maartendemunck/earth-rover/software/remote-control/human-machine-interface-display/images/layout-active-off.png

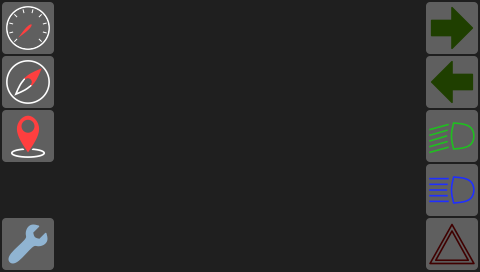
software/remote-control/human-machine-interface-display/images/layout-active-off.png
