maartendemunck/earth-rover/software/remote-control/human-machine-interface-display/images/layout-page-compass.png

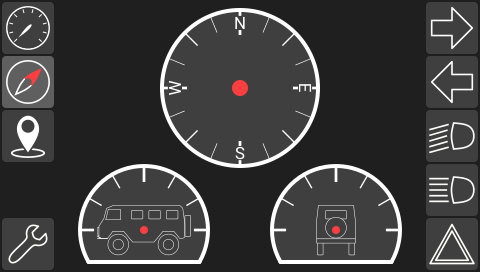
software/remote-control/human-machine-interface-display/images/layout-page-compass.png
