maartendemunck/earth-rover/software/remote-control/human-machine-interface-display/images/layout-page-gps.png

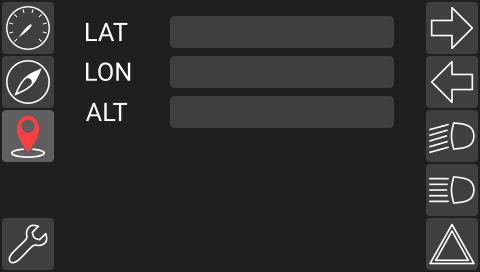
software/remote-control/human-machine-interface-display/images/layout-page-gps.png
