maartendemunck/earth-rover/software/remote-control/human-machine-interface-display/images/layout-page-speedometer.png

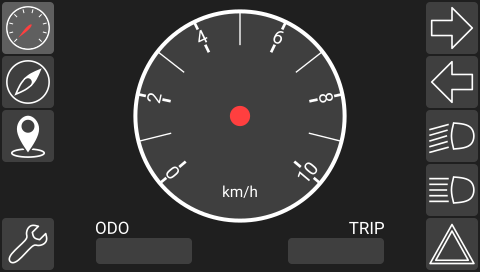
software/remote-control/human-machine-interface-display/images/layout-page-speedometer.png
