maartendemunck/earth-rover/software/remote-control/human-machine-interface-display/images/layout-settings-page-gearbox-active.png

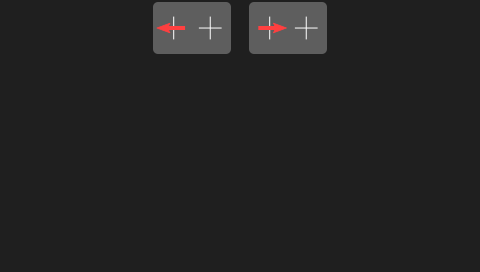
software/remote-control/human-machine-interface-display/images/layout-settings-page-gearbox-active.png
