maartendemunck/earth-rover/software/remote-control/human-machine-interface-display/images/layout-settings-page-gearbox.png

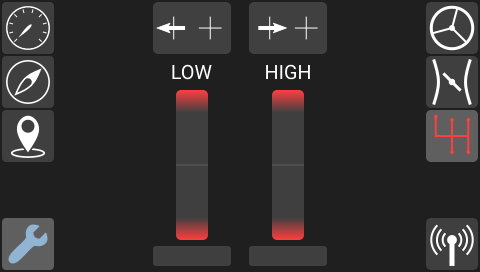
software/remote-control/human-machine-interface-display/images/layout-settings-page-gearbox.png
