maartendemunck/earth-rover/software/remote-control/human-machine-interface-display/images/layout-settings-page-steering-active.png

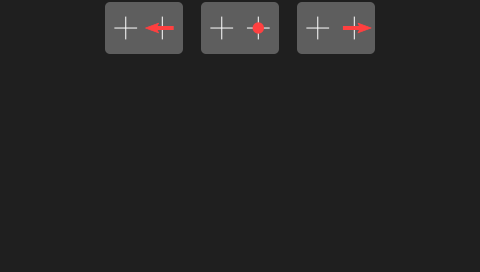
software/remote-control/human-machine-interface-display/images/layout-settings-page-steering-active.png
