maartendemunck/earth-rover/software/remote-control/human-machine-interface-display/images/layout-settings-page-steering.png

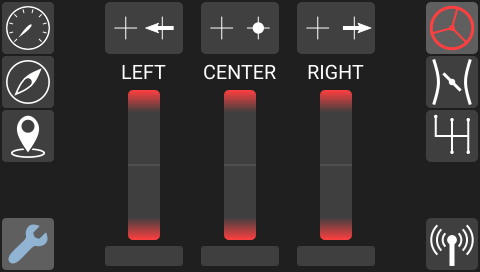
software/remote-control/human-machine-interface-display/images/layout-settings-page-steering.png
