maartendemunck/earth-rover/documentation/src/images/electronics-block-diagram.pdf

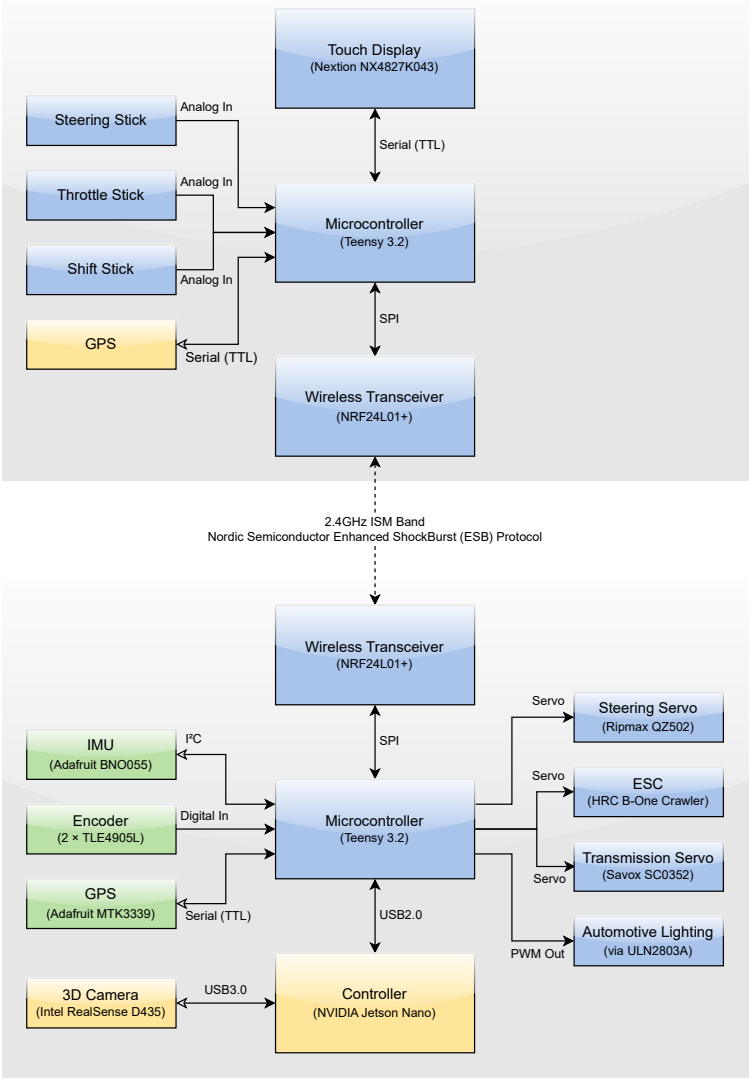
[picture p11: page 1]
Serial (TTL); Touch Display (Nextion NX4827K043); SPI; Microcontroller (Teensy 3.2); Analog In; Steering Stick; 2.4GHz ISM Band; Wireless Transceiver; (NRF24L01+); Wireless Transceiver (NRF24L01+); USB2.0; Servo; PWM Out; Throttle Stick; Shift Stick; I²C IMU; (Adafruit BNO055); GPS; (Adafruit MTK3339); ESC; Steering Servo; (Ripmax QZ502); Transmission Servo (Savox SC0352); USB3.0 3D Camera; (Intel RealSense D435); Automotive Lighting; (via ULN2803A)

Nordic Semiconductor Enhanced ShockBurst (ESB) Protocol

(HRC B-One Crawler)

Digital In Encoder
(2 × TLE4905L)

Controller
(NVIDIA Jetson Nano)
