maartendemunck/earth-rover/documentation/src/images/software-block-diagram.pdf

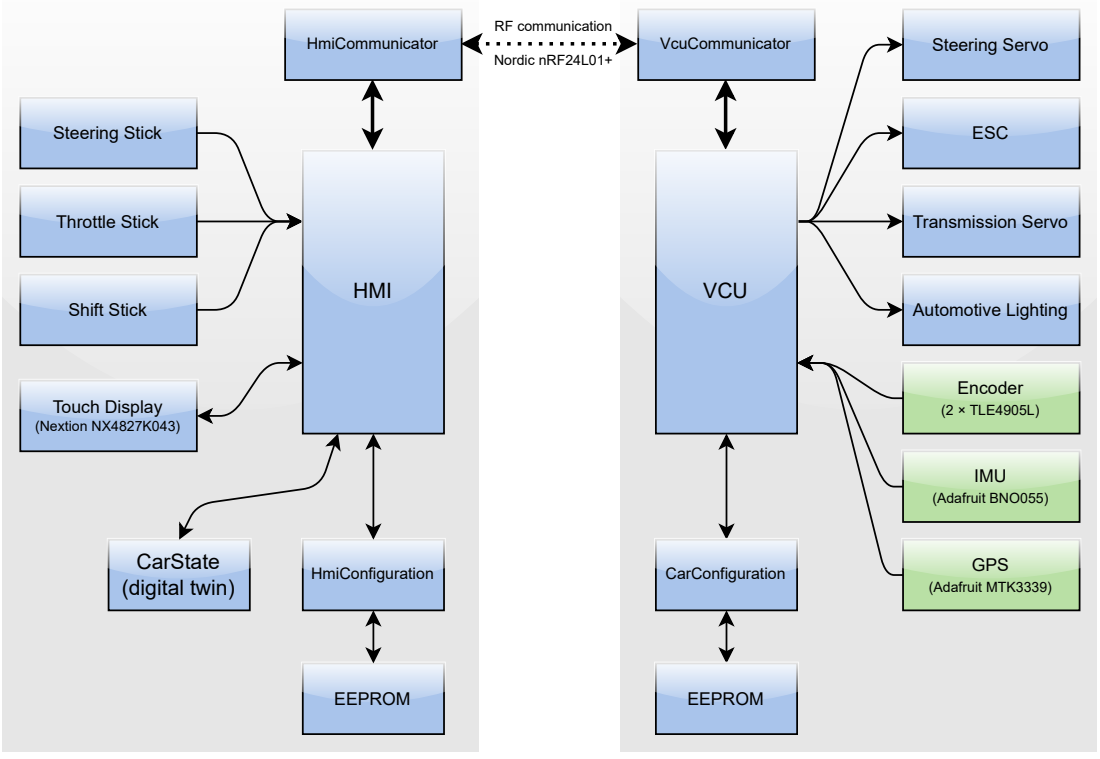
[picture p12: page 1]
Touch Display (Nextion NX4827K043); Steering Stick; VcuCommunicator; Throttle Stick; Shift Stick; Encoder; (2 × TLE4905L); IMU; (Adafruit BNO055); GPS; (Adafruit MTK3339); ESC; Steering Servo; Transmission Servo; Automotive Lighting; HMI; RF communication; Nordic nRF24L01+; HmiCommunicator; VCU; CarConfiguration; EEPROM; HmiConfiguration; CarState (digital twin)
