maartendemunck/earth-rover/electronics/vehicle-control-unit/vehicle-control-unit.kicad_pcb

## KiCad design electronics/vehicle-control-unit/vehicle-control-unit.kicad_pcb (2023-01-23)

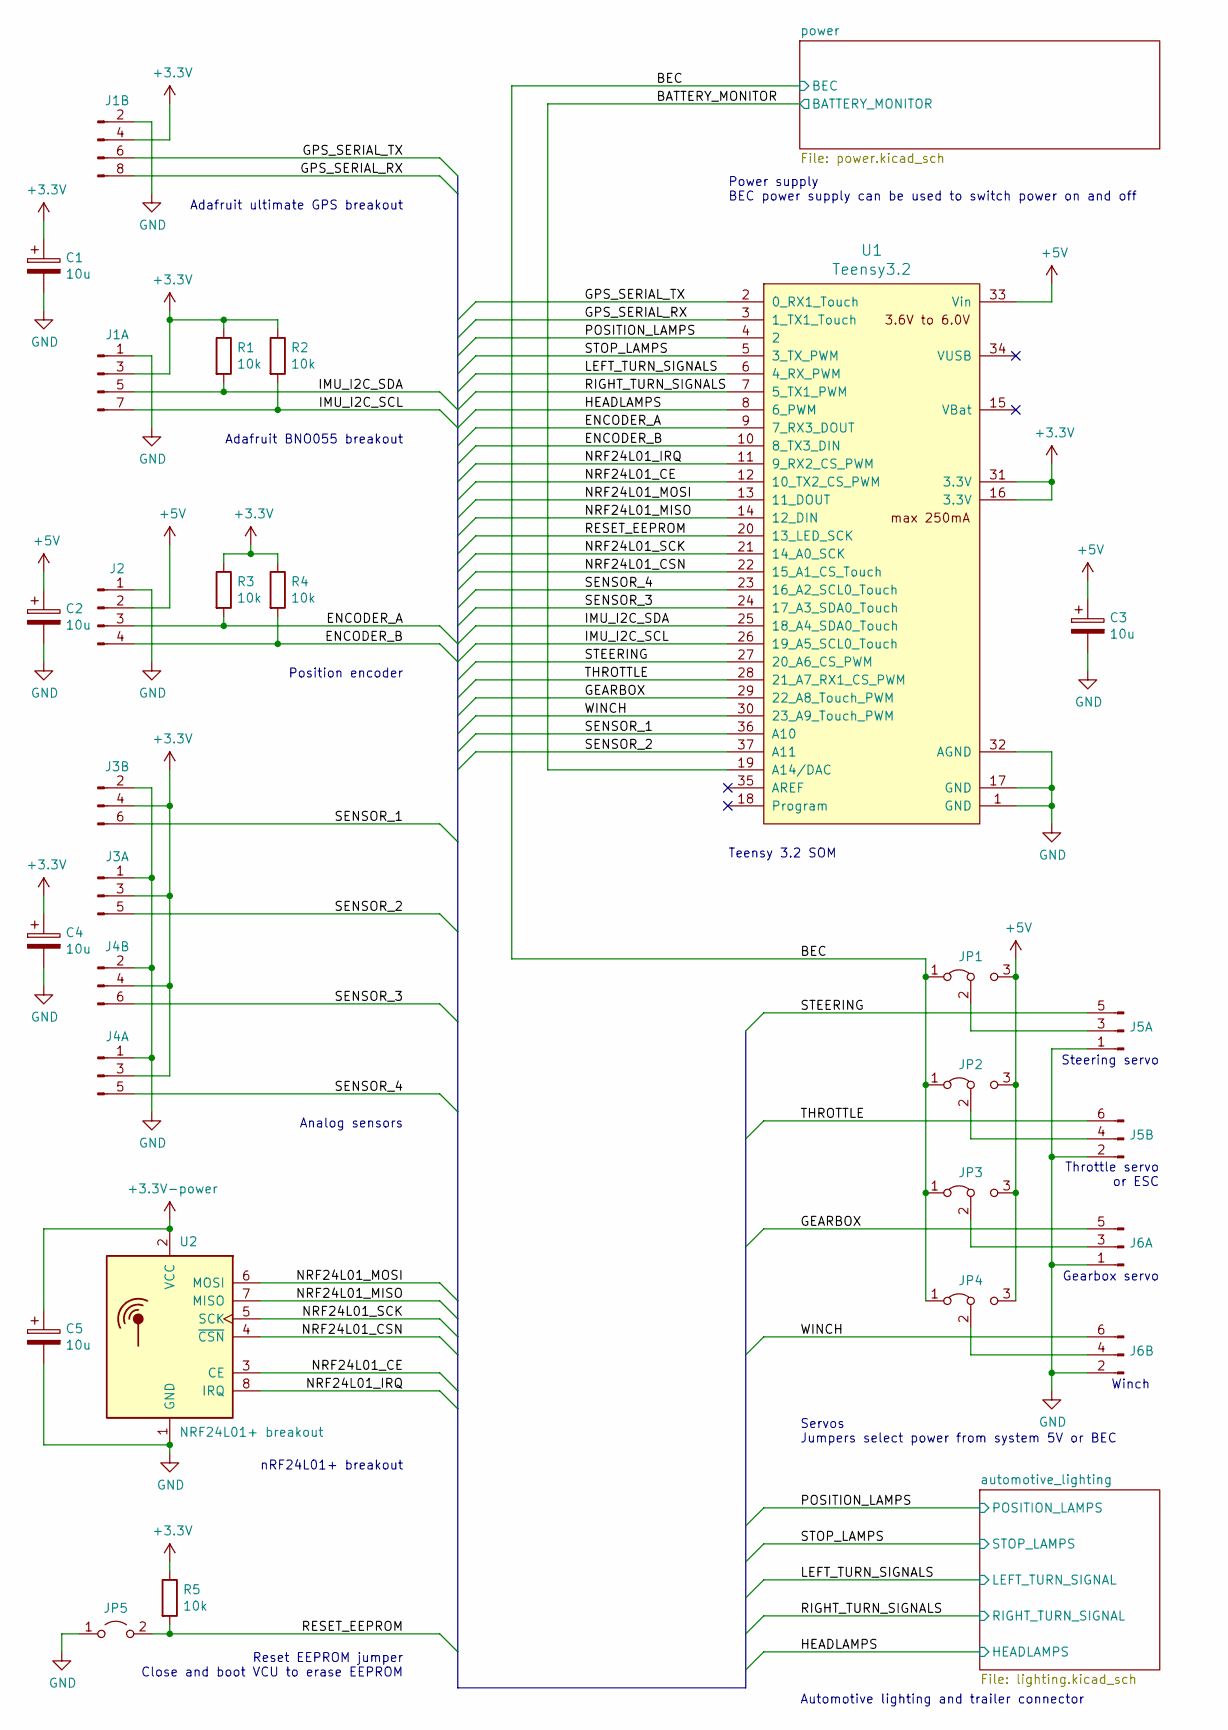
[picture p13: schematic vehicle-control-unit.kicad_sch, Earth Rover]

Parts:
C1, C2, C3, C4, C5: 10u; CP_Radial_D5.0mm_P2.50mm
J1: Conn_02x04_Male_UnitPerRow; PinHeader_2x04_P2.54mm_Horizontal
J2: Conn_01x04_Male; PinHeader_1x04_P2.54mm_Horizontal
J3, J4, J5, J6: Conn_02x03_Male; PinHeader_2x03_P2.54mm_Horizontal
JP1, JP2, JP3, JP4: Jumper_3_Bridged12; PinHeader_1x03_P2.54mm_Vertical
JP5: Jumper_2_Open; PinHeader_1x02_P2.54mm_Vertical
R1, R2, R3, R4, R5: 10k; R_Axial_DIN0207_L6.3mm_D2.5mm_P10.16mm_Horizontal
U1: Teensy3.2; Teensy_3.2
U2: NRF24L01+ breakout; nRF24L01_Breakout_LargerHoles

Connections:
+5V: C2.1, C3.1, J2.2, JP1.3 (B), JP2.3 (B), JP3.3 (B), JP4.3 (B), U1.33 (Vin); also elsewhere on the board
/BATTERY_MONITOR: U1.19 (A14/DAC); also elsewhere on the board
/BEC: JP1.1 (A), JP2.1 (A), JP3.1 (A), JP4.1 (A); also elsewhere on the board
/ENCODER_A: J2.3, R3.2, U1.9 (7_RX3_DOUT)
/ENCODER_B: J2.4, R4.2, U1.10 (8_TX3_DIN)
/GEARBOX: J6.5, U1.29 (22_A8_Touch_PWM)
/GPS_SERIAL_RX: J1.8, U1.3 (1_TX1_Touch)
/GPS_SERIAL_TX: J1.6, U1.2 (0_RX1_Touch)
/HEADLAMPS: U1.8 (6_PWM); also elsewhere on the board
/IMU_I2C_SCL: J1.7, R2.2, U1.26 (19_A5_SCL0_Touch)
/IMU_I2C_SDA: J1.5, R1.2, U1.25 (18_A4_SDA0_Touch)
/LEFT_TURN_SIGNALS: U1.6 (4_RX_PWM); also elsewhere on the board
/NRF24L01_CE: U1.12 (10_TX2_CS_PWM), U2.3 (CE)
/NRF24L01_CSN: U1.22 (15_A1_CS_Touch), U2.4 (~CSN)
/NRF24L01_IRQ: U1.11 (9_RX2_CS_PWM), U2.8 (IRQ)
/NRF24L01_MISO: U1.14 (12_DIN), U2.7 (MISO)
/NRF24L01_MOSI: U1.13 (11_DOUT), U2.6 (MOSI)
/NRF24L01_SCK: U1.21 (14_A0_SCK), U2.5 (SCK)
/POSITION_LAMPS: U1.4 (2); also elsewhere on the board
/RESET_EEPROM: JP5.2 (B), R5.2, U1.20 (13_LED_SCK)
/RIGHT_TURN_SIGNALS: U1.7 (5_TX1_PWM); also elsewhere on the board
/SENSOR_1: J3.6, U1.36 (A10)
/SENSOR_2: J3.5, U1.37 (A11)
/SENSOR_3: J4.6, U1.24 (17_A3_SDA0_Touch)
/SENSOR_4: J4.5, U1.23 (16_A2_SCL0_Touch)
/STEERING: J5.5, U1.27 (20_A6_CS_PWM)
/STOP_LAMPS: U1.5 (3_TX_PWM); also elsewhere on the board
/THROTTLE: J5.6, U1.28 (21_A7_RX1_CS_PWM)
/WINCH: J6.6, U1.30 (23_A9_Touch_PWM)
GND: C1.2, C2.2, C3.2, C4.2, C5.2, J1.1, J1.2, J2.1, J3.1, J3.2, J4.1, J4.2, J5.1, J5.2, J6.1, J6.2, JP5.1 (A), U1.1 (GND), U1.17 (GND), U1.32 (AGND), U2.1 (GND); also elsewhere on the board
unnamed: J5.3, JP1.2 (C)
unnamed: J5.4, JP2.2 (C)
unnamed: J6.3, JP3.2 (C)
unnamed: J6.4, JP4.2 (C)

Notes on the sheet:
Adafruit ultimate GPS breakout
Automotive lighting and trailer connector
Reset EEPROM jumper Close and boot VCU to erase EEPROM
Throttle servo or ESC
Adafruit BNO055 breakout
Steering servo
Power supply BEC power supply can be used to switch power on and off
Gearbox servo
Analog sensors
nRF24L01+ breakout
Winch
Servos Jumpers select power from system 5V or BEC
Teensy 3.2 SOM
Position encoder

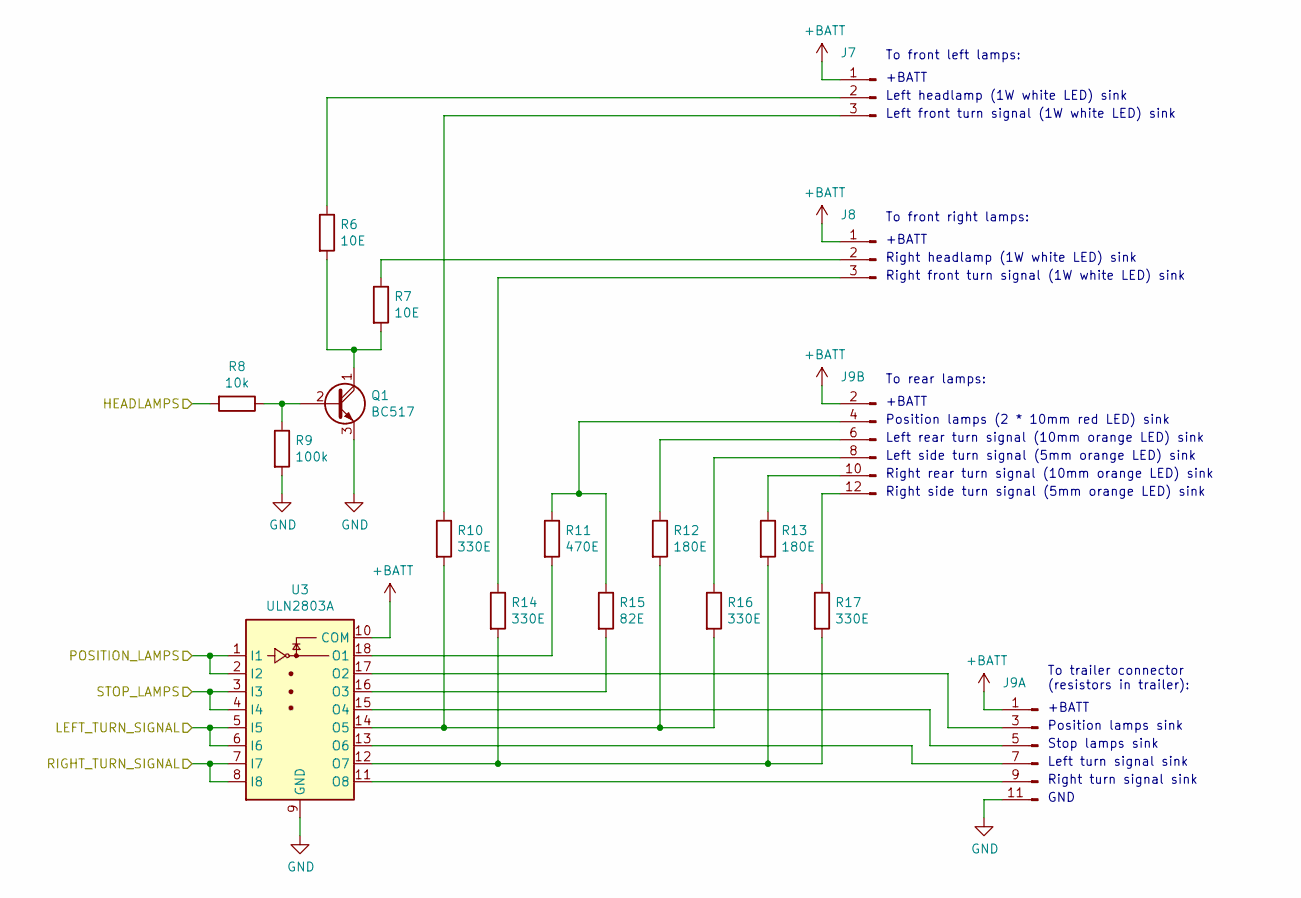
[picture p14: schematic lighting.kicad_sch, Earth Rover]

Parts:
J7, J8: Conn_01x03_Male; PinHeader_1x03_P2.54mm_Horizontal
J9: Conn_02x06_Male_UnitPerRow; PinHeader_2x06_P2.54mm_Horizontal
Q1: BC517; TO-92_Inline
R6, R7: 10E; R_Axial_DIN0207_L6.3mm_D2.5mm_P10.16mm_Horizontal
R8: 10k; R_Axial_DIN0207_L6.3mm_D2.5mm_P10.16mm_Horizontal
R9: 100k; R_Axial_DIN0207_L6.3mm_D2.5mm_P10.16mm_Horizontal
R10, R14, R16, R17: 330E; R_Axial_DIN0207_L6.3mm_D2.5mm_P10.16mm_Horizontal
R11: 470E; R_Axial_DIN0207_L6.3mm_D2.5mm_P10.16mm_Horizontal
R12, R13: 180E; R_Axial_DIN0207_L6.3mm_D2.5mm_P10.16mm_Horizontal
R15: 82E; R_Axial_DIN0207_L6.3mm_D2.5mm_P10.16mm_Horizontal
U3: ULN2803A; DIP-18_W7.62mm

Connections:
+BATT: J7.1, J8.1, J9.1, J9.2, U3.10 (COM); also elsewhere on the board
/HEADLAMPS: R8.2; also elsewhere on the board
/LEFT_TURN_SIGNALS: U3.5 (I5), U3.6 (I6); also elsewhere on the board
/POSITION_LAMPS: U3.1 (I1), U3.2 (I2); also elsewhere on the board
/RIGHT_TURN_SIGNALS: U3.7 (I7), U3.8 (I8); also elsewhere on the board
/STOP_LAMPS: U3.3 (I3), U3.4 (I4); also elsewhere on the board
GND: J9.11, Q1.3 (E), R9.2, U3.9 (GND); also elsewhere on the board
unnamed: J7.2, R6.1
unnamed: J7.3, R10.1
unnamed: J8.2, R7.1
unnamed: J8.3, R14.1
unnamed: J9.3, U3.17 (O2)
unnamed: J9.4, R11.1, R15.1
unnamed: J9.5, U3.15 (O4)
unnamed: J9.6, R12.1
unnamed: J9.7, U3.13 (O6)
unnamed: J9.8, R16.1
unnamed: J9.9, U3.11 (O8)
unnamed: J9.10, R13.1
unnamed: J9.12, R17.1
unnamed: Q1.1 (C), R6.2, R7.2
unnamed: Q1.2 (B), R8.1, R9.1
unnamed: R10.2, R12.2, R16.2, U3.14 (O5)
unnamed: R11.2, U3.18 (O1)
unnamed: R13.2, R14.2, R17.2, U3.12 (O7)
unnamed: R15.2, U3.16 (O3)

Notes on the sheet:
+BATT
GND
Stop lamps sink
Position lamps sink
Left front turn signal (1W white LED) sink
Left rear turn signal (10mm orange LED) sink
To rear lamps:
Left turn signal sink
To front left lamps:
Right front turn signal (1W white LED) sink
Right side turn signal (5mm orange LED) sink
To front right lamps:
Right rear turn signal (10mm orange LED) sink
Left headlamp (1W white LED) sink
Right turn signal sink
To trailer connector (resistors in trailer):
Right headlamp (1W white LED) sink
Position lamps (2 * 10mm red LED) sink
Left side turn signal (5mm orange LED) sink

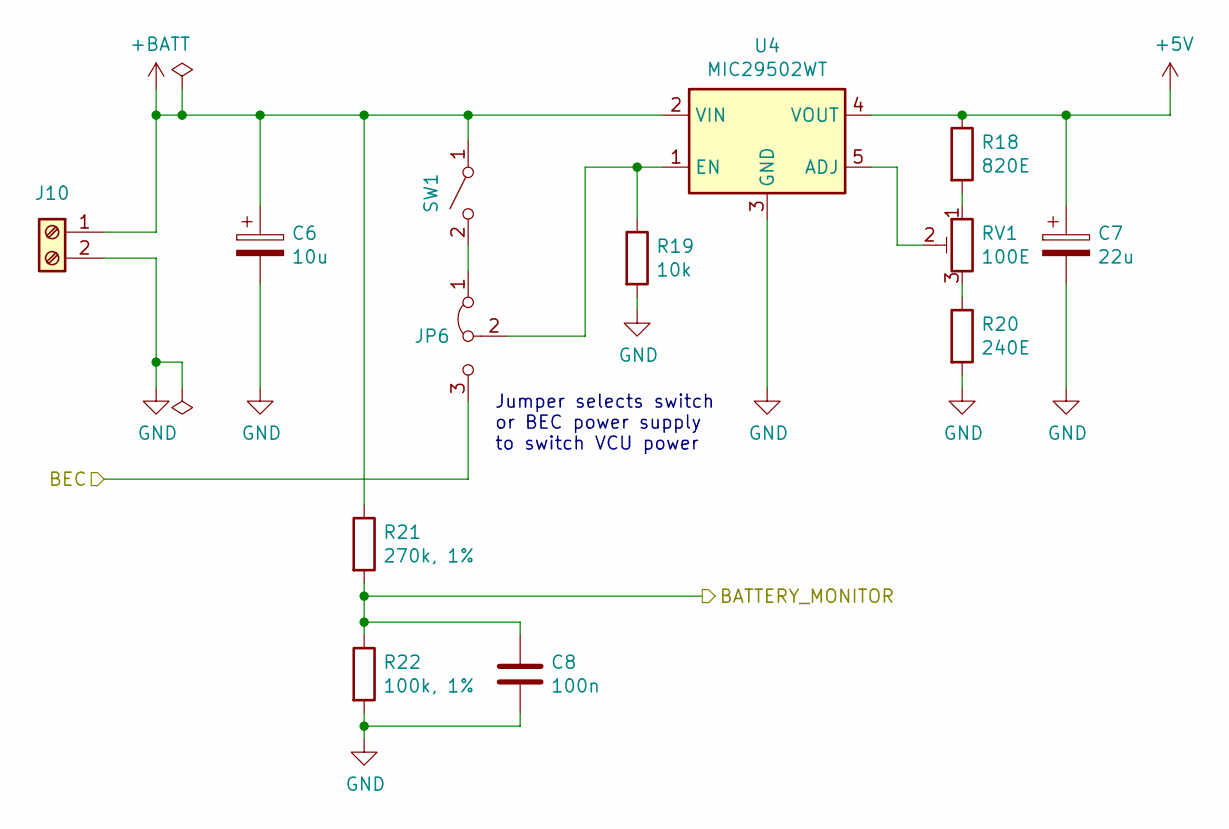
[picture p15: schematic power.kicad_sch, Earth Rover]

Parts:
C6: 10u; CP_Radial_D5.0mm_P2.50mm
C7: 22u; CP_Radial_D5.0mm_P2.50mm
C8: 100n; C_Disc_D5.0mm_W2.5mm_P5.00mm
J10: Connector:Screw_Terminal_01x02; TerminalBlock_bornier-2_P5.08mm
JP6: Jumper_3_Bridged12; PinHeader_1x03_P2.54mm_Vertical
R18: 820E; R_Axial_DIN0207_L6.3mm_D2.5mm_P10.16mm_Horizontal
R19: 10k; R_Axial_DIN0207_L6.3mm_D2.5mm_P10.16mm_Horizontal
R20: 240E; R_Axial_DIN0207_L6.3mm_D2.5mm_P10.16mm_Horizontal
R21: 270k, 1%; R_Axial_DIN0207_L6.3mm_D2.5mm_P10.16mm_Horizontal
R22: 100k, 1%; R_Axial_DIN0207_L6.3mm_D2.5mm_P10.16mm_Horizontal
RV1: 100E; Potentiometer_Bourns_3296W_Vertical
SW1: SW_SPST; PinHeader_1x02_P2.54mm_Horizontal
U4: MIC29502WT; TO-220-5_P3.4x3.8mm_StaggerEven_Lead7.13mm_TabDown

Connections:
+5V: C7.1, R18.1, U4.4 (VOUT); also elsewhere on the board
+BATT: C6.1, J10.1, R21.1, SW1.1 (A), U4.2 (VIN); also elsewhere on the board
/BATTERY_MONITOR: C8.1, R21.2, R22.1; also elsewhere on the board
/BEC: JP6.3 (B); also elsewhere on the board
GND: C6.2, C7.2, C8.2, J10.2, R19.2, R20.2, R22.2, U4.3 (GND); also elsewhere on the board
unnamed: JP6.1 (A), SW1.2 (B)
unnamed: JP6.2 (C), R19.1, U4.1 (EN)
unnamed: R18.2, RV1.1
unnamed: R20.1, RV1.3
unnamed: RV1.2, U4.5 (ADJ)

Notes on the sheet:
Jumper selects switch or BEC power supply to switch VCU power

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
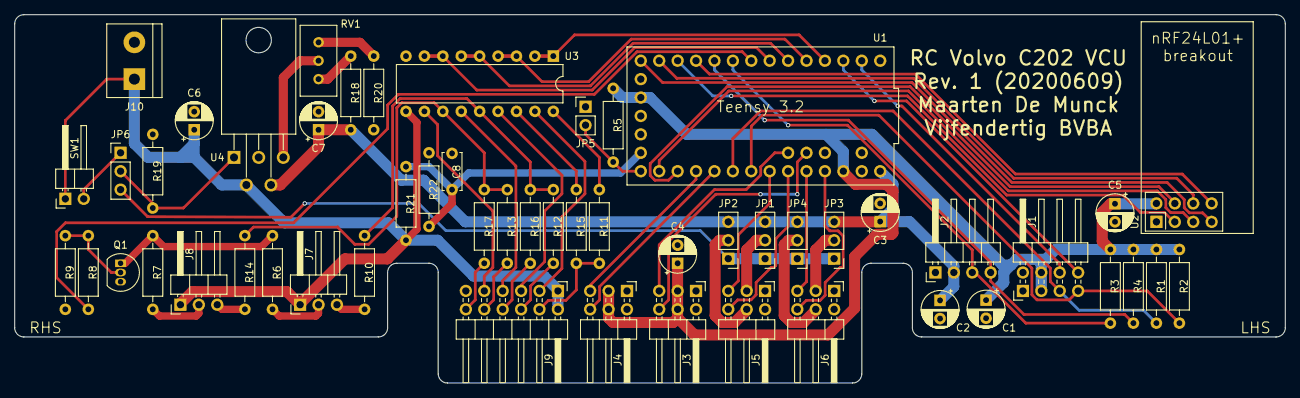
[picture p16: board vehicle-control-unit.kicad_pcb from above]

Board: 2 copper layers, 175.3 x 50.8 mm, 53 parts (0 on the bottom side), 60 nets.
