maartendemunck/earth-rover/electronics/position-encoder/position-encoder.kicad_pcb

## KiCad design electronics/position-encoder/position-encoder.kicad_pcb (2023-01-23)

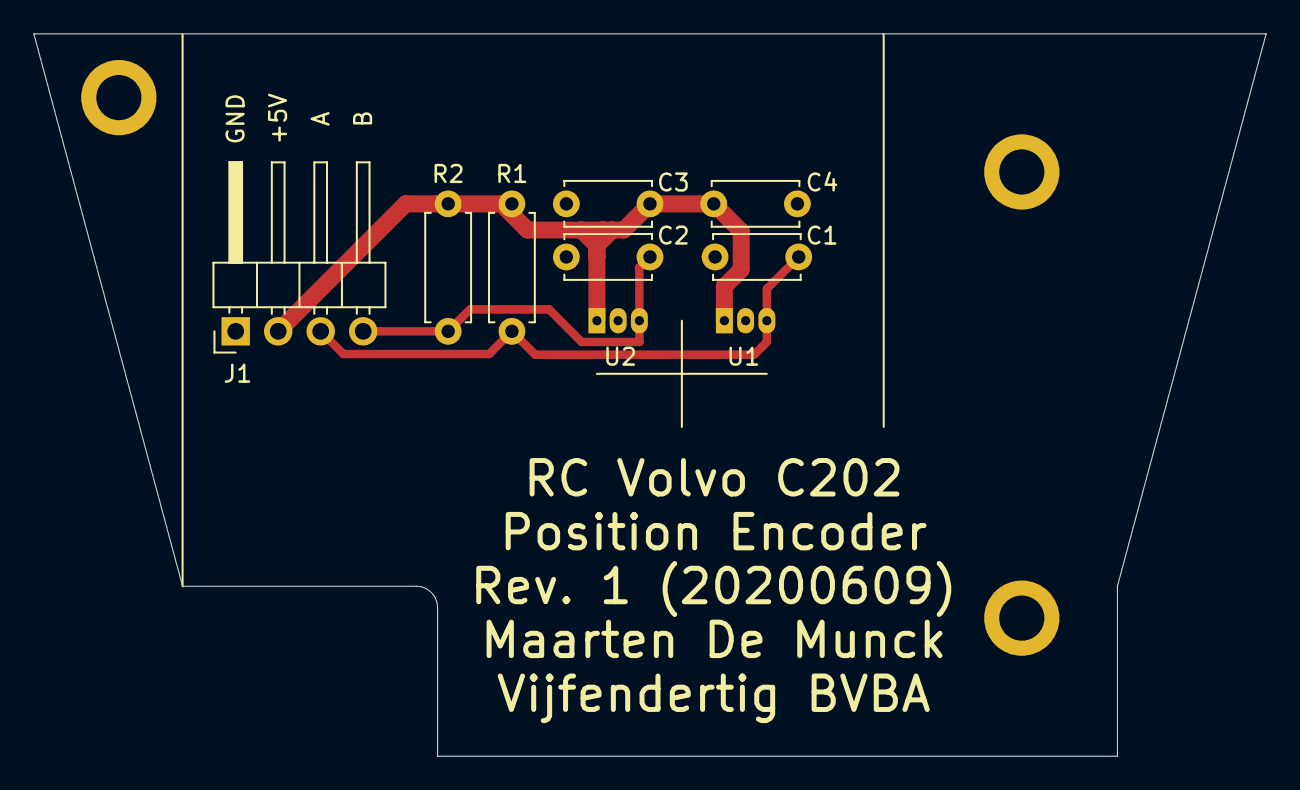
[picture p17: board position-encoder.kicad_pcb from above]

Board: 2 copper layers, 73.7 x 43.2 mm, 9 parts (0 on the bottom side), 4 nets.

Parts:
C1, C2, C3, C4: 4.7nF; C_Disc_D5.0mm_W2.5mm_P5.00mm
J1: Conn_01x04_Male; PinHeader_1x04_P2.54mm_Horizontal
R1, R2: 10kΩ; R_Axial_DIN0207_L6.3mm_D2.5mm_P7.62mm_Horizontal
U1, U2: TLE4905L; PG-SSO-3-2_W2.54mm_Horizontal_Down

Connections:
+5V: C3.1, C4.1, J1.2, R1.1, R2.1, U1.1, U2.1
GND: C1.2, C2.2, C3.2, C4.2, J1.1, U1.2, U2.2
unnamed: C1.1, J1.3, R1.2, U1.3
unnamed: C2.1, J1.4, R2.2, U2.3
