maartendemunck/earth-rover/electronics/human-machine-interface/human-machine-interface.kicad_pcb

## KiCad design electronics/human-machine-interface/human-machine-interface.kicad_pcb (2023-01-23)

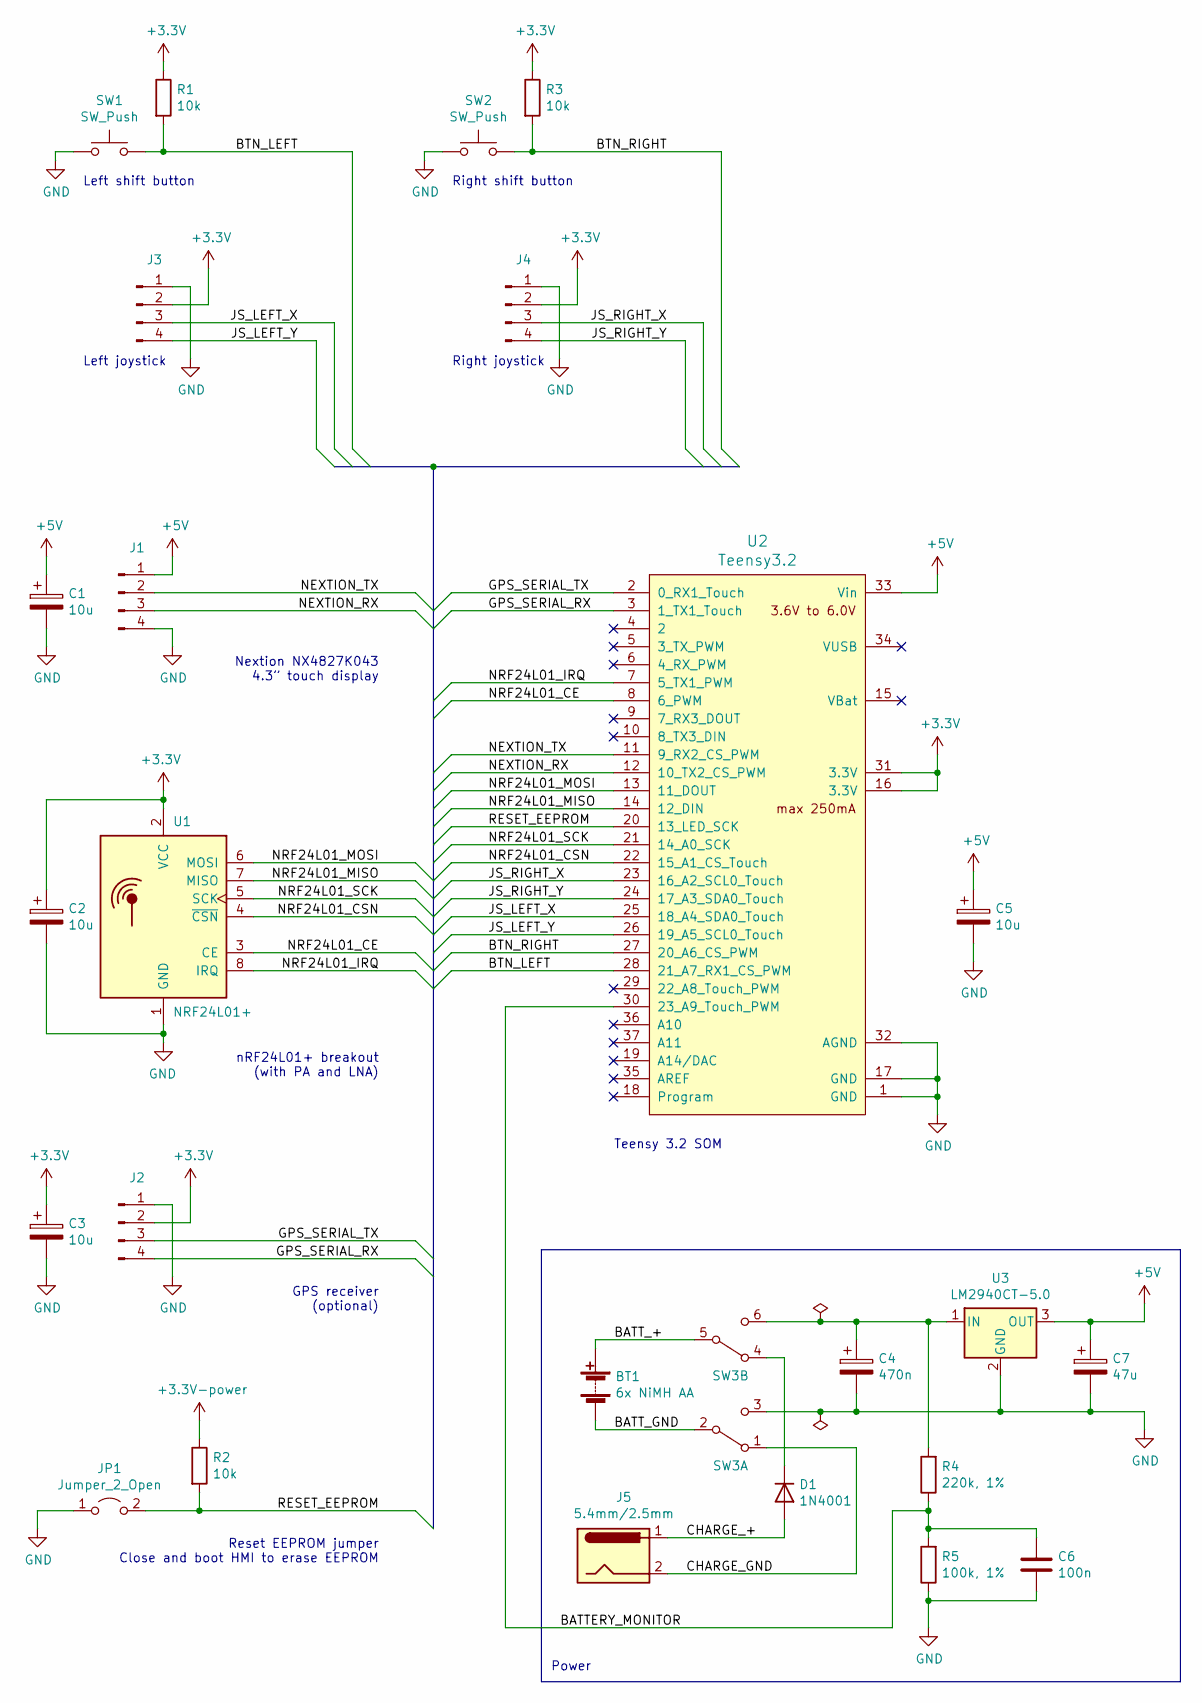
[picture p18: schematic human-machine-interface.kicad_sch, Earth Rover]

Parts:
BT1: 6x NiMH AA; PinHeader_1x02_P2.54mm_Vertical
C1, C2, C3, C5: 10u; CP_Radial_D5.0mm_P2.50mm
C4: 470n; C_Rect_L10.0mm_W5.0mm_P5.00mm_P7.50mm
C6: 100n; C_Rect_L10.0mm_W5.0mm_P5.00mm_P7.50mm
C7: 47u; CP_Radial_D5.0mm_P2.50mm
D1: 1N4001; D_DO-41_SOD81_P10.16mm_Horizontal
J1, J2, J3, J4: Conn_01x04_Male; PinHeader_1x04_P2.54mm_Vertical
J5: 5.4mm/2.5mm; PinHeader_1x02_P2.54mm_Vertical
JP1: Jumper_2_Open; PinHeader_1x02_P2.54mm_Vertical
R1, R2, R3: 10k; R_Axial_DIN0207_L6.3mm_D2.5mm_P10.16mm_Horizontal
R4: 220k, 1%; R_Axial_DIN0207_L6.3mm_D2.5mm_P10.16mm_Horizontal
R5: 100k, 1%; R_Axial_DIN0207_L6.3mm_D2.5mm_P10.16mm_Horizontal
SW1, SW2: SW_Push; PinHeader_1x02_P2.54mm_Vertical
SW3: SW_DPDT_x2; PinHeader_2x03_P2.54mm_Vertical_Switch_DPDT
U1: NRF24L01+; nRF24L01_Breakout_LargerHoles
U2: Teensy3.2; Teensy_3.2
U3: LM2940CT-5.0; TO-220-3_Vertical

Connections:
+5V: C1.1, C5.1, C7.1, J1.1, U2.33 (Vin), U3.3 (OUT)
/BATTERY_MONITOR: C6.1, R4.1, R5.2, U2.30 (23_A9_Touch_PWM)
/BATT_+: BT1.1 (+), SW3.5 (B)
/BATT_GND: BT1.2 (-), SW3.2 (B)
/BTN_LEFT: R1.2, SW1.2, U2.28 (21_A7_RX1_CS_PWM)
/BTN_RIGHT: R3.2, SW2.2, U2.27 (20_A6_CS_PWM)
/CHARGE_+: D1.2 (A), J5.1
/CHARGE_GND: J5.2, SW3.1 (A)
/GPS_SERIAL_RX: J2.4, U2.3 (1_TX1_Touch)
/GPS_SERIAL_TX: J2.3, U2.2 (0_RX1_Touch)
/JS_LEFT_X: J3.3, U2.25 (18_A4_SDA0_Touch)
/JS_LEFT_Y: J3.4, U2.26 (19_A5_SCL0_Touch)
/JS_RIGHT_X: J4.3, U2.23 (16_A2_SCL0_Touch)
/JS_RIGHT_Y: J4.4, U2.24 (17_A3_SDA0_Touch)
/NEXTION_RX: J1.3, U2.12 (10_TX2_CS_PWM)
/NEXTION_TX: J1.2, U2.11 (9_RX2_CS_PWM)
/NRF24L01_CE: U1.3 (CE), U2.8 (6_PWM)
/NRF24L01_CSN: U1.4 (~CSN), U2.22 (15_A1_CS_Touch)
/NRF24L01_IRQ: U1.8 (IRQ), U2.7 (5_TX1_PWM)
/NRF24L01_MISO: U1.7 (MISO), U2.14 (12_DIN)
/NRF24L01_MOSI: U1.6 (MOSI), U2.13 (11_DOUT)
/NRF24L01_SCK: U1.5 (SCK), U2.21 (14_A0_SCK)
/RESET_EEPROM: JP1.2 (B), R2.2, U2.20 (13_LED_SCK)
GND: C1.2, C2.2, C3.2, C4.2, C5.2, C6.2, C7.2, J1.4, J2.1, J3.1, J4.1, JP1.1 (A), R5.1, SW1.1, SW2.1, SW3.3 (C), U1.1 (GND), U2.1 (GND), U2.17 (GND), U2.32 (AGND), U3.2 (GND)
unnamed: C4.1, R4.2, SW3.6 (C), U3.1 (IN)
unnamed: D1.1 (K), SW3.4 (A)

Notes on the sheet:
Power
Nextion NX4827K043 4.3” touch display
Right shift button
Right joystick
nRF24L01+ breakout (with PA and LNA)
Reset EEPROM jumper Close and boot HMI to erase EEPROM
Teensy 3.2 SOM
Left joystick
Left shift button
GPS receiver (optional)

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
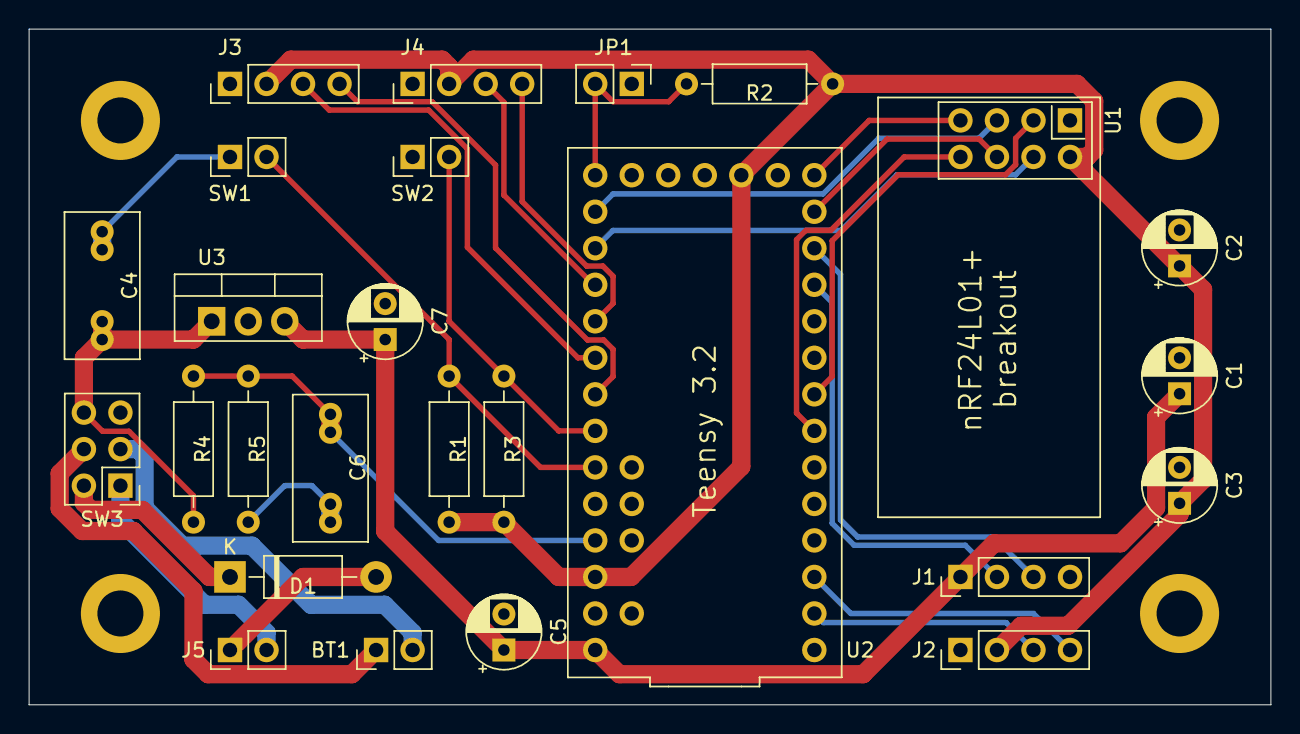
[picture p19: board human-machine-interface.kicad_pcb from above]

Board: 2 copper layers, 86.4 x 47.0 mm, 26 parts (0 on the bottom side), 27 nets.
