maartendemunck/earth-rover/software/remote-control/human-machine-interface/test/test-car-state/test-main.cpp

#ifdef UNIT_TEST

#include "test-configuration-parameter.hpp"
#include "test-gearbox-servo-state.hpp"
#include "test-radio-state.hpp"
#include "test-servo-state.hpp"
#include <unity.h>

int main(int argc, char **argv) {
    UNITY_BEGIN();
    RUN_TEST(testConfigParameter);
    RUN_TEST(testServoConfigParams);
    RUN_TEST(testServoState);
    RUN_TEST(testGearboxServoConfigParams);
    RUN_TEST(testGearboxServoState);
    RUN_TEST(testRadioConfigParams);
    UNITY_END();
}

#endif
