maartendemunck/earth-rover/software/remote-control/human-machine-interface/test/test-car-state/test-gearbox-servo-state.hpp

#ifdef UNIT_TEST

#ifndef __EARTH_ROVER_HMI__TEST_GEARBOX_SERVO_STATE__
#define __EARTH_ROVER_HMI__TEST_GEARBOX_SERVO_STATE__

void testGearboxServoConfigParams();
void testGearboxServoState();

#endif

#endif
