maartendemunck/earth-rover/(commit log)

2019-06-22 Documentation updates and Makefile
    Add the pin assignment on the HMI's Teensy 3.2 microcontroller.
    Add a Makefile for the documentation (calling lyx).
2019-07-08 Transmit 2 analog values via nRF24L01+
    Implement a prototype transmitting two analog values over the nRF24L01+
    transceivers.
2019-07-09 Clean up HMI prototype code
2019-07-09 Clean up VCU prototype code
2019-07-09 Add steering and throttle servo control to VCU
2019-09-08 Fix bugs in FHSS
    Fix bug in FHSS receiver code.
    Replace channel list by something that works reliable with my Velleman
    nRF24L01+ modules.
    [hmi-communicator.cpp, hmi-communicator.hpp, main.cpp, vcu-communicator.hpp]
2019-09-12 Fix servo initialization and only shift while driving
    Fix servo initialization. The steering servo requires an additional
    setPosition call (on top of the call in the setup function) to prevent
    fully steering to the left until the synchronization with the
    transmitter is established.
    Only shift while driving to ensure quick engagement, lowering the stress
    on the gearbox servo.
    [main.cpp]
2019-09-18 Add Adafruit Bosch BNO055 sensor
2019-09-22 Add GPS sensor and location and altitude request and response
2019-09-23 Improve sensor data handling
2019-10-03 Add distance and speed encoder
2019-10-04 Embed GPS functionality in a separate class
    Embed the GPS functionality in a separate NeoGPS wrapper class, moving
    the details (the serial device and its configuration and initialization
    and the data processing) outside the Vcu class.
2019-10-06 Add wrapper for the BNO055 IMU and add documentation
    Add a device-independent-interface-wrapper for the Adafruit BNO055 IMU.
    Continue documenting all code.
2019-10-07 Fix potential bug and add documentation
    Fix potential bug (potential incompatibility with non-Teense boards) in
    position encoder.
    Add documentation.
    [isr-wrapper.hpp, position-encoder.hpp, vcu.hpp]
2019-10-07 Fix bug and add documentation
    Fix bug in servo pulse width limitations.
    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
    [adafruit-bno055-wrapper.hpp, configured-servo.cpp, configured-servo.hpp, isr-wrapper.hpp, neogps-wrapper.hpp, position-encoder.hpp, vcu.hpp]
2019-10-15 Refactor steering servo and powertrain configuration
2019-10-16 Fix default pulse widths
    [powertrain.cpp, steering-servo.cpp]
2019-10-16 Request and receive steering configuration
    Request steering servo configuration and process received answer.
    Enable configuration pages when configuration in HMI is complete
    (currently when the steering configuration is received). This also
    required a change in the Nextion HMI code (variable name too long
    apparently).
    [car-state.cpp, car-state.hpp, configuration-parameter.hpp, hmi-communicator.cpp, hmi-communicator.hpp, nextion-hmi-display.hpp]
2019-10-17 Request and receive throttle and gearbox configuration
2019-10-17 Fix missed first message from Nextion HMI display
    [main.cpp, nextion-hmi-display.hpp]
2019-10-18 Apply steering servo and powertrain configuration
    Apply steering servo and powertrain configuration received from HMI.
    Simplified gearbox servo configuration (assume two speed with neutral
    except in the communication protocol itself).
2019-10-20 Apply radio PA power level configuration
2019-10-27 Fix bug displaying pitch and roll values < -45 degrees
    [nextion-hmi-display.hpp]
2019-10-27 Save IMU calibration to EEPROM and restore it on boot
2019-10-28 Save steering configuration to EEPROM and restore it on boot
2019-10-29 Save powertrain configuration to EEPROM and restore it on boot and fix bugs
    [main.cpp, powertrain.cpp, powertrain.hpp, steering-servo.hpp, vcu.hpp]
2019-10-29 Add IMU calibration to EEPROM reset code
    [main.cpp]
2019-10-30 Fix IMU orientation (yaw)
    [adafruit-bno055-wrapper.hpp]
2019-11-11 Add circuit diagram for position encoder
    [position-encoder.kicad_pcb, position-encoder.sch]
2019-11-11 Add repo with circuit diagrams and PCB layouts as a submodule
2019-11-13 Add PCB for position encoder
    [position-encoder.kicad_pcb, position-encoder.sch]
2019-11-14 Update PCB
    [position-encoder.kicad_pcb]
2019-11-14 Improve PCB
    [position-encoder.kicad_pcb]
2019-11-21 Add custom KiCad page layout
    [position-encoder.sch]
2019-11-24 Add HMI schematic
    [human-machine-interface.sch]
2019-11-25 Improve layout of HMI schematic
    [human-machine-interface.sch]
2019-11-25 Add (optional) GPS receiver to HMI schematic
    [human-machine-interface.sch]
2019-11-29 Add part of VCU schematic
    [lighting.sch, power.sch, vehicle-control-unit.sch]
2019-11-30 Finish VCU schematic
    [lighting.sch, power.sch, vehicle-control-unit.sch]
2019-12-01 Improve layouts and add capacitors
    [human-machine-interface.sch, lighting.sch, position-encoder.sch, power.sch, vehicle-control-unit.sch]
2019-12-06 Add Alps Alpine ThumbPointer RKJXK122000D footprint
    [human-machine-interface.sch]
2019-12-12 Move the HMI's thumbsticks to separate boards
    [human-machine-interface.sch, joystick.sch]
2019-12-14 Update power supply of HMI
    [human-machine-interface.sch]
2019-12-20 Review schematics
    [human-machine-interface.sch, joystick.sch, lighting.sch, position-encoder.sch, power.sch, vehicle-control-unit.sch]
2019-12-21 Correct resistor value for battery monitor
    [human-machine-interface.sch, lighting.sch, power.sch, vehicle-control-unit.sch]
2019-12-23 Add PCB for joystick breakout board
    [joystick.kicad_pcb, joystick.sch]
2020-01-31 Add pulldown resistor on MIC29502WT's EN input
    [power.sch]
2020-02-23 Fix some errors in the VCU hardware
    [lighting.sch, power.sch, vehicle-control-unit.sch]
2020-02-23 Add diode to HMI's charge port
    [human-machine-interface.sch]
2020-02-23 Add schematics and software as used in prototype
2020-04-25 Wire all turn signal LEDs in parallel
    [lighting.sch, power.sch, vehicle-control-unit.sch]
2020-04-27 Fix missing pinMode in destructor
    [lighting.cpp]
2020-04-27 Fix typo in comment
    [main.cpp]
2020-06-01 Assign footprints
    [lighting.sch, power.sch, vehicle-control-unit.sch]
2020-06-01 Draw PCB outline
    [vehicle-control-unit.kicad_pcb]
2020-06-08 Route PCB
    [lighting.sch, power.sch, vehicle-control-unit.kicad_pcb, vehicle-control-unit.sch]
2020-06-08 Clean up routing
    [lighting.sch, power.sch, vehicle-control-unit.kicad_pcb, vehicle-control-unit.sch]
2020-06-08 Finish VCU PCB
    [vehicle-control-unit.kicad_pcb]
2020-06-09 Update PCB of position encoder
    [position-encoder.kicad_pcb]
2020-06-09 Improve ground plane of VCU PCB
    [vehicle-control-unit.kicad_pcb]
2020-06-09 Change mounting hole diameter to 2.54mm
    [position-encoder.kicad_pcb]
2020-06-11 Update joystick breakout board
    [joystick.kicad_pcb, joystick.sch]
2020-06-12 Route HMI PCB
    [human-machine-interface.kicad_pcb, human-machine-interface.sch]
2020-06-12 Finish HMI PCB
    [human-machine-interface.kicad_pcb]
2020-06-12 Use proper mounting holes
    [human-machine-interface.kicad_pcb, joystick.kicad_pcb, position-encoder.kicad_pcb]
2020-06-12 Add panel
    [earth-rover-panel-finished.kicad_pcb, earth-rover-panel.kicad_pcb]
2020-06-17 Update panel according to Eurocircuits' specifications
    [earth-rover-panel-finished.kicad_pcb, earth-rover-panel.kicad_pcb]
2020-06-23 Use larger holes for nRF24L01+ breakout board
    [earth-rover-panel-finished.kicad_pcb, earth-rover-panel.kicad_pcb, human-machine-interface.kicad_pcb, human-machine-interface.sch, vehicle-control-unit.kicad_pcb, vehicle-control-unit.sch]
2020-08-05 Change value of rear turn signal resistors
    [lighting.sch, power.sch, vehicle-control-unit.kicad_pcb, vehicle-control-unit.sch]
2023-01-23 Update human machine interface to KiCad 6.0
    [human-machine-interface.kicad_pcb, human-machine-interface.kicad_sch, human-machine-interface.sch]
2023-01-23 Update joystick breakout board to KiCad 6.0
    [joystick.kicad_pcb, joystick.kicad_sch, joystick.sch]
2023-01-23 Update position encoder to KiCad 6.0
    [position-encoder.kicad_pcb, position-encoder.kicad_sch, position-encoder.sch]
2023-01-23 Update VCU to KiCad 6.0
    [lighting.kicad_sch, lighting.sch, power.kicad_sch, power.sch, vehicle-control-unit.kicad_pcb, vehicle-control-unit.kicad_sch, vehicle-control-unit.sch]
2023-01-23 Update panel to KiCad 6.0
    [earth-rover-panel-finished.kicad_pcb, earth-rover-panel.kicad_pcb]
2023-01-23 Remove old KiCad libraries
2023-03-17 Improve and refactor HMI (incl Nextion display)
    Implement the configuration of the HMI. The center and extreme positions
    of the sticks can be teached via the menu on the Nextion display. These
    settings are stored in the non-volatile memory (EEPROM) of the HMI
    itself.
    Improve high beam handling. The high beam is automatically switched of
    when the low beam is off, similar to real cars.
    Refactor the Teensy firmware, focusing on self-documenting code instead of
    Doxygen comments.
    Use 115200 baud for communication with Nextion HMI
2023-03-17 Refactor VCU Teensy firmware
2023-03-19 Fix bugs sending and saving the configuation
    Fix bugs in sending the configuration from the HMI to the VCU and saving
    the configuration in the EEPROM of the VCU.
    Handle the transmission as a two speed transmission (low and high, no
    neutral). Initialise the transmission on the average of low and high and
    move to either low or high as soon as the car starts driving. This
    prevents putting too much strain on the transmission servo if the car is
    switched off in second gear and cannot easily switch to first gear.
    [car-state.cpp, car-state.hpp, configuration-parameter.hpp, hmi-communicator.cpp, nextion-hmi-display.hpp, powertrain.cpp, powertrain.hpp, vcu-communicator.hpp]
2023-03-19 Fix some potential code issues
    [adafruit-bno055.hpp, car-state.hpp, configuration-parameter.hpp, configured-servo.hpp, gearbox-servo-state.hpp, hmi-communicator.hpp, hmi-state.hpp]
2023-03-19 Fix communication error in HMI
    [nextion-hmi-display.hpp]
